alecampo01/Hardware-P3/Diagrama de bloques/diagrama_de_bloques.jpeg

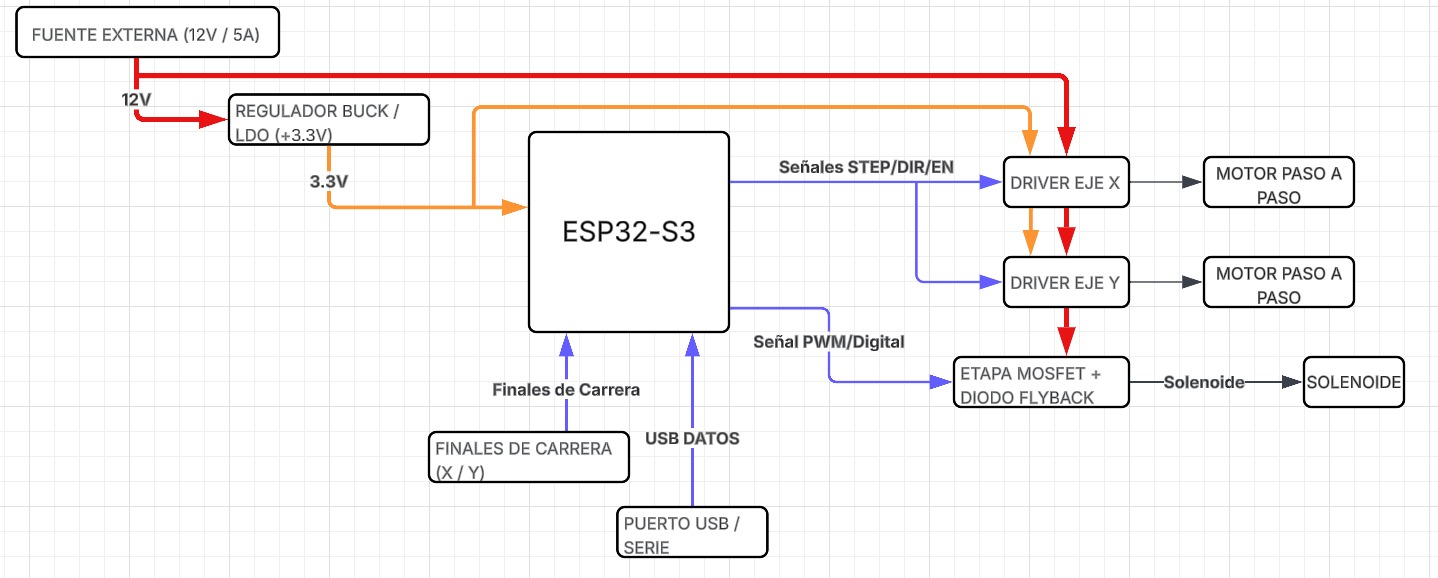
Diagrama de bloques/diagrama_de_bloques.jpeg
