alecampo01/Hardware-P3/ListaDeCompras.xlsx

 | MICROCONTROLADOR
N° | Componente | Cantidad | Precio C/U | Total C/elemento | Link de Compra
1 | ESP32-S3-WROOM-1-N8R2 | 2 | 5.71 | 11.42 | https://www.mouser.com/ProductDetail/Espressif-Systems/ESP32-S3-WROOM-1-N8R2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
2 | Conector de Cable JST XH2.54 XH 3Pines 5U | 1 | 0.83 | 0.83 | Conector de Cable JST XH2.54 XH, Conector de Cable de 2,54mm, 2/3/4/5/6/7/8 Pines, enchufe macho y hembra, 10cm, 20cm de longitud, 26AWG, 5 Juegos - AliExpress (https://es.aliexpress.com/item/1005007460897865.html?curPageLogUid=QL9FQO7aCmdz)
3 | USB-C | 2 | 0.94 | 1.88 | https://www.mouser.com/ProductDetail/GCT/USB4105-GF-A?qs=KUoIvG%2F9IlY%2FMLlBMpStpA%3D%3D
4 | TS-1088-AR02016 SMD 10U | 1 | 0.93 | 0.93 | (10/50/100 piezas) TS-1088-AR02016 SMD 4x3mm Botón pulsador redondo unipolar de 1.6N 4x3x2mm Interruptor táctil de montaje en superficie (https://es.aliexpress.com/item/1005011943648412.html?curPageLogUid=kW8MJiTtlRvl)
5 | B330-13-F | 1 | 0.63 | 0.63 | https://www.mouser.com/ProductDetail/Diodes-Incorporated/B330-13-F?qs=5Tgt%2F%252B%252B8UCehJdUN1WXRnw%3D%3D
6 | IRLZ44NSTRLPBF | 1 | 1.85 | 1.85 | https://www.mouser.com/ProductDetail/Infineon-Technologies/IRLZ44NSTRLPBF?qs=9%252BKlkBgLFf1LijFJvUznEg%3D%3D
7 | TAU-0826B 20N | 1 | 1.29 | 1.29 | https://es.aliexpress.com/item/32618031228.html?curPageLogUid=pLduYfAZWpfP
8 | Capacitor 22uF/25V | 2 | 0.54 | 1.08 | https://www.mouser.com/ProductDetail/Samsung-Electro-Mechanics/CL21X226MAYNNWE
9 | Capacitor 0.1uF=100nF/50V | 4 | 0.14 | 0.56 | https://www.mouser.com/ProductDetail/KEMET/C0805C104J5RAC3123?qs=gbgtKHXraGH3IyMRQDl%252BcQ%3D%3D
10 | Capacitor 1uF | 2 | 0.26 | 0.52 | https://www.mouser.com/ProductDetail/KEMET/C0805C105M4REC7210
11 | Resistor 100ohm | 2 | 0.1 | 0.2 | https://www.mouser.com/ProductDetail/Bourns/CR0805-JW-101ELF?qs=wL7NMIHXUPl5EcPQbx1sug%3D%3D
12 | Resistor 10kohm | 2 | 0.1 | 0.2 | https://www.mouser.com/ProductDetail/Bourns/CR0805-JW-103ELF?qs=3T0Ne7aOLxCPz7FUKqmeVw%3D%3D
13 | Resistor 220ohm | 2 | 0.1 | 0.2 | https://www.mouser.com/ProductDetail/Panasonic/ERJ-6GEYJ221V?qs=mVvrpt%2FmFGaxvxGYT57NXw%3D%3D
14 | Resistor 5.1kohm | 4 | 0.1 | 0.4 | https://www.mouser.com/ProductDetail/Bourns/CR0805-FX-5101ELF
15 | SS-01GL | 2 | 3.4 | 6.8 | https://www.mouser.com/ProductDetail/Omron-Electronics/SS-01GL?qs=Pjd0UV7BHP91yVT1VU12sw%3D%3D
 |  |  | Total | 28.79
 | DRIVERS
N° | Componentes | Cantidad | Precio C/U | Total C/elemento | Link de Compra
1 | DRV8825 | 3 | 4.99 | 14.97 | https://www.mouser.com/ProductDetail/Texas-Instruments/DRV8825PWPR?qs=L4ss%2FyqpMWRQV%252B0JWK8r%2FQ%3D%3D
2 | Conector de Cable JST XH2.54 XH 4Pines 5U | 1 | 0.9 | 0.9 | https://es.aliexpress.com/item/1005007460897865.html
3 | NEMA17 17HS4401 3U | 1 | 21.58 | 21.58 | https://es.aliexpress.com/item/1005006111249881.html?curPageLogUid=EycNEFFyzhpI
4 | Capacitor Electrolitico 100uF/35V | 3 | 0.35 | 1.05 | https://www.mouser.com/ProductDetail/Wurth-Elektronik/865080545012
5 | Capacitor Electrolitico 0.01uF/50V | 3 | 2.54 | 7.62 | https://www.mouser.com/ProductDetail/KEMET/C0805C103F5GACAUTO
6 | Capacitor 0.1uF=100nF/50V | 6 | 0.14 | 0.84 | https://www.mouser.com/ProductDetail/KEMET/C0805C104J5RAC3123?qs=gbgtKHXraGH3IyMRQDl%252BcQ%3D%3D
7 | Capacitor 0.47uF/25V | 3 | 0.23 | 0.69 | https://www.mouser.com/ProductDetail/KEMET/C0805C474M3RECTU
8 | Resistor 1Mohm | 3 | 0.1 | 0.3 | https://www.mouser.com/ProductDetail/Bourns/CR0805-FX-1004ELF?qs=tknLyCMIRbOGJekSMom0SQ%3D%3D
9 | Resistor 0.2ohm | 6 | 0.2 | 1.2 | https://www.mouser.com/ProductDetail/Bourns/CRL0805-JW-R200ELF?qs=OcJ73dDx4S2T7WJh28otdg%3D%3D
10 | Resistor 50kohm | 3 | 2.25 | 6.75 | https://www.mouser.com/ProductDetail/Vishay-Draloric/TNPU080550K0AZEN00?qs=bAKSY%2FctAC6QhhNTu29n1w%3D%3D
11 | Resistor 30kohm | 3 | 0.1 | 0.3 | https://www.mouser.com/ProductDetail/Bourns/CR0805-FX-3002ELF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
12 | Resistor 10kohm | 3 | 0.1 | 0.3 | https://www.mouser.com/ProductDetail/Bourns/CR0805-FX-1002ELF?qs=tknLyCMIRbPr%252BDD0s0nG9g%3D%3D
 |  |  | Total | 56.5
 | REGULADORES
N° | Componentes | Cantidad | Precio C/U | Total C/elemento | Link de Compra
1 | MP2393GTL-Z | 2 | 1.5 | 3 | https://www.mouser.com/ProductDetail/Monolithic-Power-Systems-MPS/MP2393GTL-Z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
2 | LM1117MPX-3.3/NOPB | 1 | 1.04 | 1.04 | https://www.mouser.com/ProductDetail/Texas-Instruments/LM1117MPX-3.3-NOPB?qs=X1J7HmVL2ZHRbBIxXi4utg%3D%3D
3 | LTST-C193KRKT-2A | 2 | 0.17 | 0.34 | https://www.mouser.com/ProductDetail/LITEON/LTST-C193KRKT-2A?qs=gTYE2QTfZfR%2Fn%2F75wQdYig%3D%3D
4 | DMP3130L-7 | 1 | 0.57 | 0.57 | https://www.mouser.com/ProductDetail/Diodes-Incorporated/DMP3130L-7?qs=oUsD4qhOtFzo1DjIYBcgCA%3D%3D
5 | BAT760-7 | 1 | 0.55 | 0.55 | https://www.mouser.com/ProductDetail/Diodes-Incorporated/BAT760-7?qs=JV7lzlMm3yKDDyO09xoRbQ%3D%3D
6 | L 4.7uH | 2 | 0.92 | 1.84 | https://www.mouser.com/ProductDetail/Vishay-Dale/IHLP1616BZER4R7M11?qs=gMuw6kkpPFgfyxuC44lHBg%3D%3D
7 | Capacitor 0.1uF=100nF/50V | 4 | 0.14 | 0.56 | https://www.mouser.com/ProductDetail/KEMET/C0805C104J5RAC3123?qs=gbgtKHXraGH3IyMRQDl%252BcQ%3D%3D
8 | Capacitor 22uF/25V | 6 | 0.54 | 3.24 | https://www.mouser.com/ProductDetail/Samsung-Electro-Mechanics/CL21X226MAYNNWE
9 | Capacitor 6.8uF/6.3V | 2 | 0.52 | 1.04 | https://www.mouser.com/ProductDetail/KEMET/C0805C685K9PACTM
10 | Capacitor 1uF | 2 | 0.26 | 0.52 | https://www.mouser.com/ProductDetail/KEMET/C0805C105M4REC7210
11 | Capacitor 10pF/35V | 2 | 0.18 | 0.36 | https://www.mouser.com/ProductDetail/KEMET/C0805C100K3RACTU
12 | Tantalum Capacitor 10uF/10V | 2 | 0.47 | 0.94 | https://www.mouser.com/ProductDetail/Vishay-Sprague/293D106X9010B2TE3
13 | Resistor 604kohm | 2 | 0.11 | 0.22 | https://www.mouser.com/ProductDetail/YAGEO/RT0805FRE07604KL
14 | Resistor 20ohm | 2 | 0.11 | 0.22 | https://www.mouser.com/ProductDetail/YAGEO/RC0805DR-0720RL?qs=9h0bZHM%2F3zKGUzWhuF%2FRhg%3D%3D
15 | Resistor 15kohm | 2 | 0.1 | 0.2 | https://www.mouser.com/ProductDetail/Bourns/CR0805-FX-1502ELF?qs=Hqdsf0hGw%2FCN5sNalLmn%252BA%3D%3D
16 | Resistor 40.2kohm | 2 | 0.1 | 0.2 | https://www.mouser.com/ProductDetail/YAGEO/RT0805FRE0740K2L
17 | Resistor 7.68kohm | 2 | 0.1 | 0.2 | https://www.mouser.com/ProductDetail/YAGEO/RT0805DRE077K68L?qs=sGAEpiMZZMtlubZbdhIBIKm0gsRX2fVkGmK9ppNE60o%3D
18 | Resistor 10kohm | 1 | 0.1 | 0.1 | https://www.mouser.com/ProductDetail/Bourns/CR0805-FX-1002ELF?qs=tknLyCMIRbPr%252BDD0s0nG9g%3D%3D
19 | Resistor 100ohm | 1 | 0.1 | 0.1 | https://www.mouser.com/ProductDetail/Bourns/CR0805-JW-101ELF?qs=wL7NMIHXUPl5EcPQbx1sug%3D%3D
 |  |  | Total | 15.24
 | COMPONENTES DONADOS
N° | Componentes | Cantidad | Precio C/U | Total C/elemento | Link de Compra
1 | Bornera 2.54mm 2pines 5U | 1 | 4.37 | 4.37 | https://es.aliexpress.com/item/4000867583795.html?curPageLogUid=YPG3fmZDelMp
2 | Fuente 12V/6A 72W | 1 | 8.44 | 8.44 | https://konext.com.py/comprar/fuente-12v-6a/
 |  |  | Total | 12.81
 |  |  | Total Proyecto | 113.34
