alecampo01/Hardware-P3/MAQUINA_DE_BRAILLE_PCB/MAQUINA_DE_BRAILLE_PCB/ass_ets/ADP122AUJZ_3_3_R7/UJ_5_ADI.step

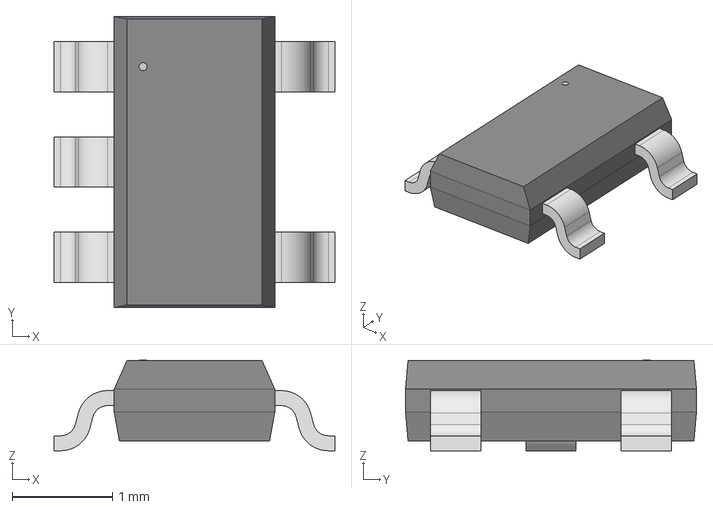
[picture p6: CAD file, 2026-03-28]
MAQUINA_DE_BRAILLE_PCB/MAQUINA_DE_BRAILLE_PCB/ass_ets/ADP122AUJZ_3_3_R7/UJ_5_ADI.step
2.80 x 2.90 x 0.903 mm
