alecampo01/Hardware-P3/MAQUINA_DE_BRAILLE_PCB/MAQUINA_DE_BRAILLE_PCB/ass_ets/BAT760_7/BAT760-7.step

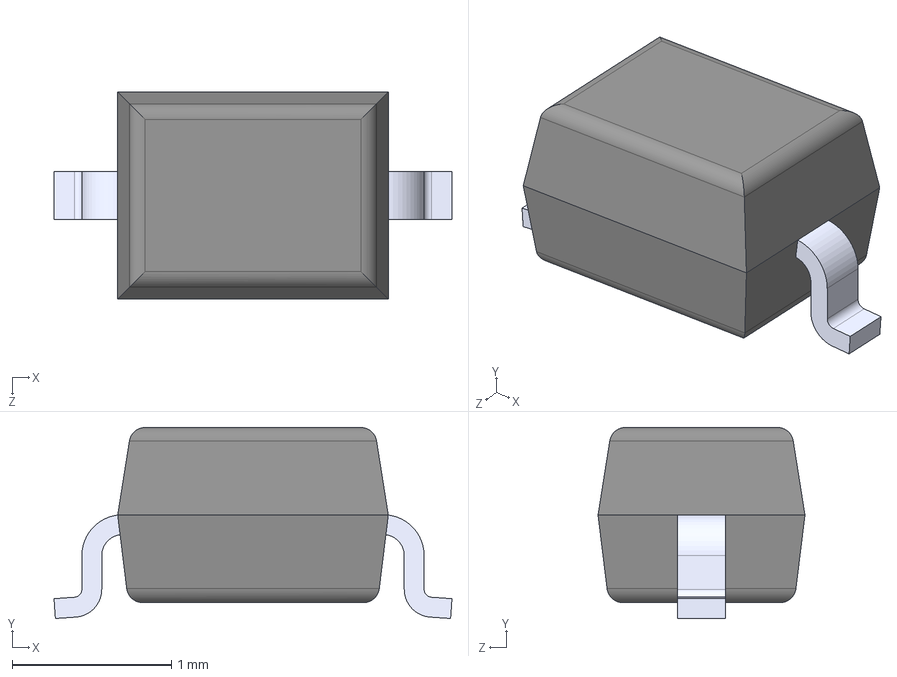
[picture p7: CAD file, 2026-03-28]
MAQUINA_DE_BRAILLE_PCB/MAQUINA_DE_BRAILLE_PCB/ass_ets/BAT760_7/BAT760-7.step
2.50 x 1.20 x 1.30 mm
