alecampo01/Hardware-P3/MAQUINA_DE_BRAILLE_PCB/MAQUINA_DE_BRAILLE_PCB/ass_ets/LTST-C193KRKT-2A/LTST-C193KRKT-2A.STEP

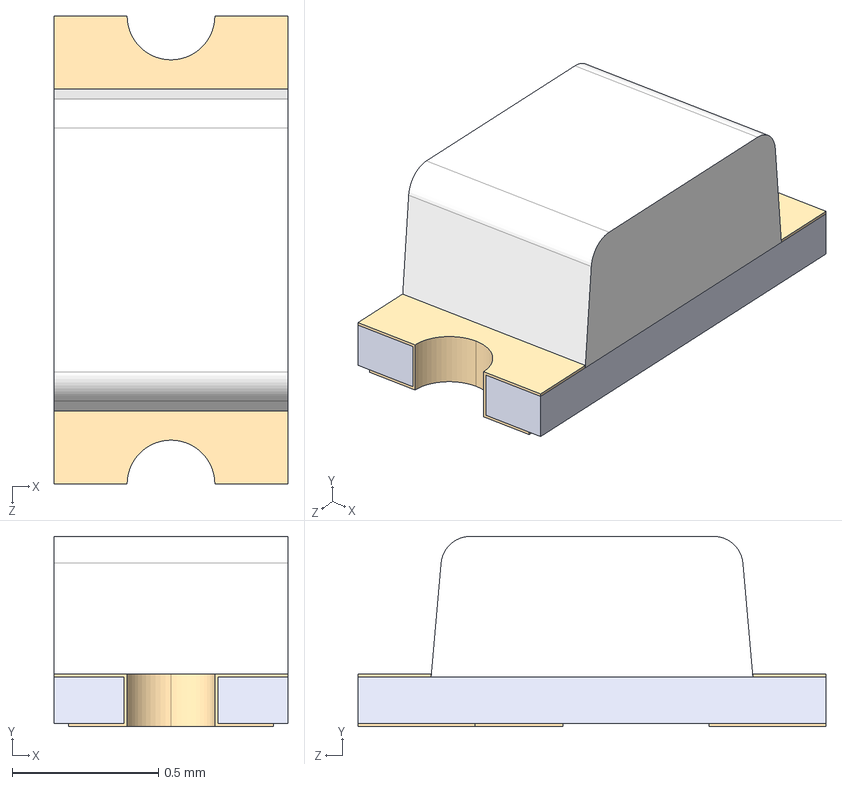
[picture p8: CAD file, 2026-03-28]
MAQUINA_DE_BRAILLE_PCB/MAQUINA_DE_BRAILLE_PCB/ass_ets/LTST-C193KRKT-2A/LTST-C193KRKT-2A.STEP
0.8 x 0.65 x 1.60 mm
