alecampo01/Hardware-P3/MAQUINA_DE_BRAILLE_PCB/MAQUINA_DE_BRAILLE_PCB/MAQUINA_DE_BRAILLE.kicad_pcb

## KiCad design MAQUINA_DE_BRAILLE_PCB/MAQUINA_DE_BRAILLE_PCB/MAQUINA_DE_BRAILLE.kicad_pcb (2026-04-25)

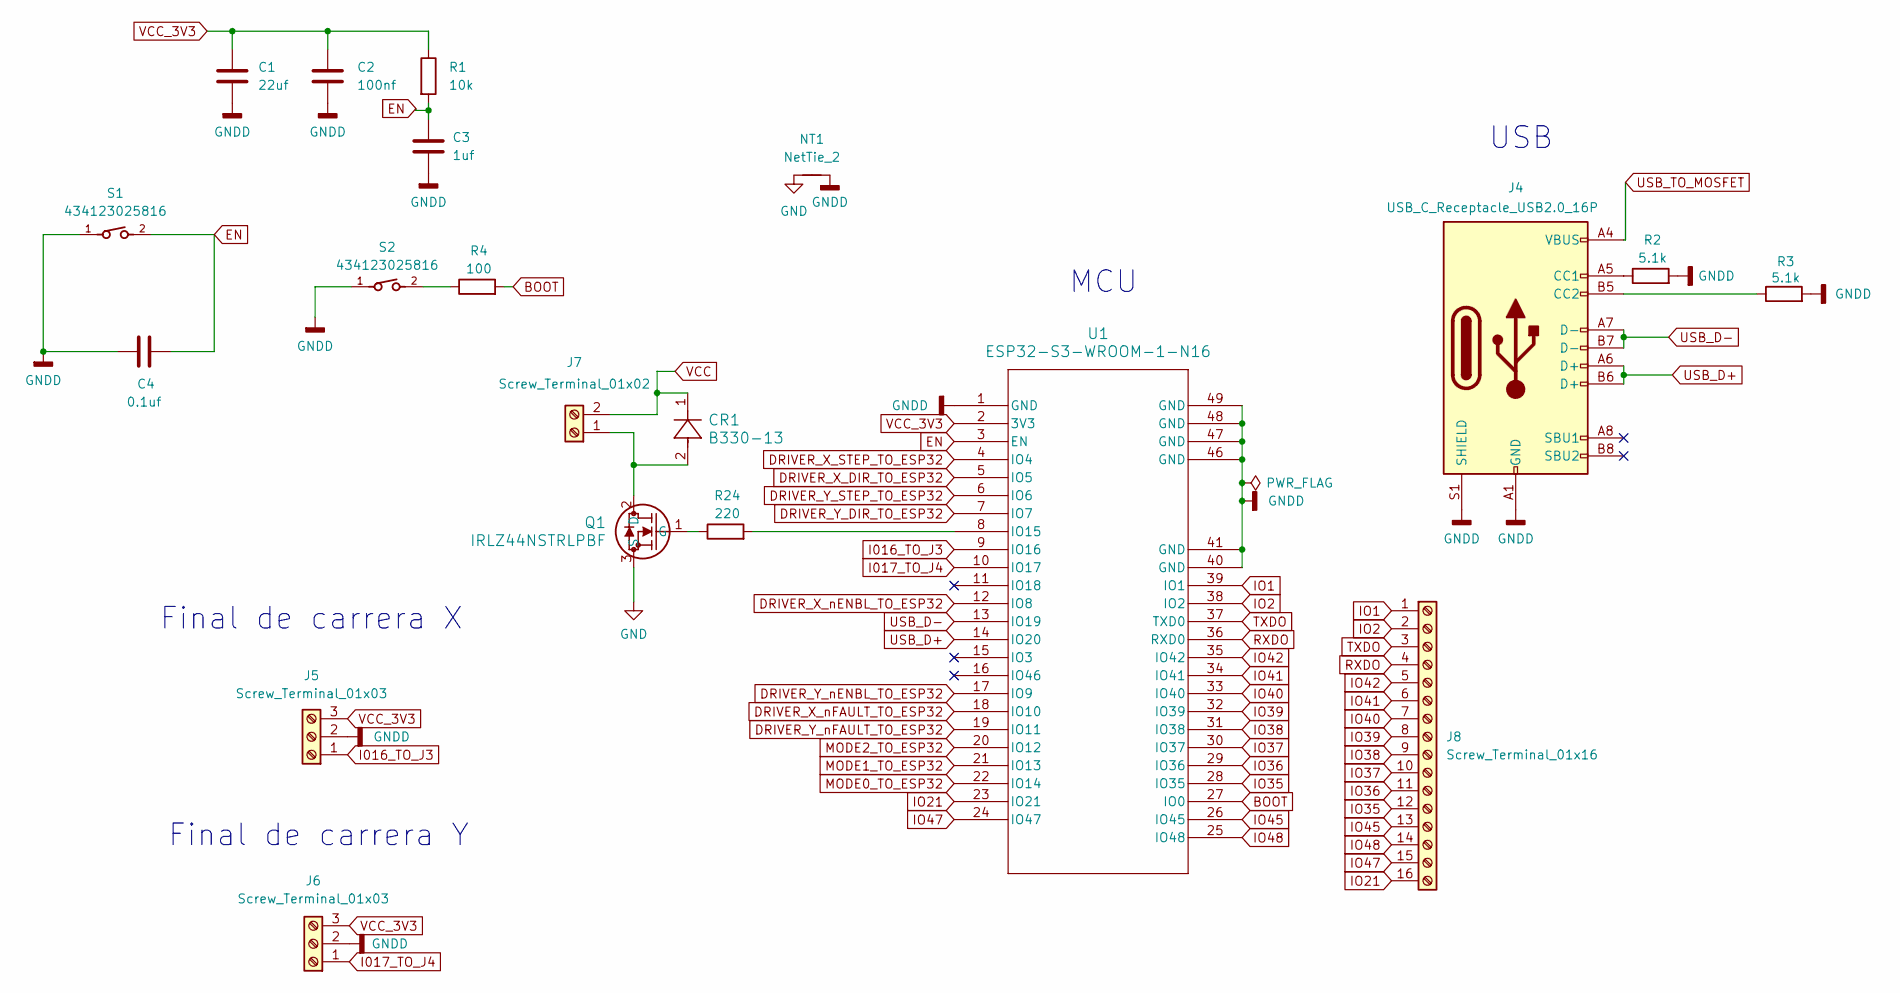
[picture p9: schematic ESP32.kicad_sch]

Parts:
C1: 22uf; C_0805_2012Metric_Pad1.18x1.45mm_HandSolder
C2: 100nf; C_0805_2012Metric_Pad1.18x1.45mm_HandSolder
C3: 1uf; C_0805_2012Metric_Pad1.18x1.45mm_HandSolder
C4: 0.1uf; C_0805_2012Metric_Pad1.18x1.45mm_HandSolder
CR1: B330-13; SMC_DIO
J4: USB_C_Receptacle_USB2.0_16P; USB_C_Receptacle_GCT_USB4105-xx-A_16P_TopMnt_Horizontal
J5, J6: Screw_Terminal_01x03; TerminalBlock_Xinya_XY308-2.54-3P_1x03_P2.54mm_Horizontal
J7: Screw_Terminal_01x02; TerminalBlock_Phoenix_MKDS-3-2-5.08_1x02_P5.08mm_Horizontal
J8: Screw_Terminal_01x16; TerminalBlock_Xinya_XY308-2.54-16P_1x16_P2.54mm_Horizontal
NT1: NetTie_2; NetTie-2_SMD_Pad2.0mm
Q1: IRLZ44NSTRLPBF; NMOSGDS_D2PAK_INF
R1: 10k; R_0805_2012Metric_Pad1.20x1.40mm_HandSolder
R2, R3: 5.1k; R_0805_2012Metric_Pad1.20x1.40mm_HandSolder
R4: 100; R_0805_2012Metric_Pad1.20x1.40mm_HandSolder
R24: 220; R_0805_2012Metric_Pad1.20x1.40mm_HandSolder
S1, S2: 434123025816
U1: ESP32-S3-WROOM-1-N16; ESP32-S3-WROOM-1_EXP

Connections:
BOOT: R4.2, U1.27 (IO0)
DRIVER_X_DIR_TO_ESP32: U1.5 (IO5); also elsewhere on the board
DRIVER_X_STEP_TO_ESP32: U1.4 (IO4); also elsewhere on the board
DRIVER_X_nENBL_TO_ESP32: U1.12 (IO8); also elsewhere on the board
DRIVER_X_nFAULT_TO_ESP32: U1.18 (IO10); also elsewhere on the board
DRIVER_Y_DIR_TO_ESP32: U1.7 (IO7); also elsewhere on the board
DRIVER_Y_STEP_TO_ESP32: U1.6 (IO6); also elsewhere on the board
DRIVER_Y_nENBL_TO_ESP32: U1.17 (IO9); also elsewhere on the board
DRIVER_Y_nFAULT_TO_ESP32: U1.19 (IO11); also elsewhere on the board
EN: C3.1, C4.2, R1.2, S1.2, U1.3 (EN); also elsewhere on the board
GND: NT1.1, Q1.3 (S); also elsewhere on the board
GNDD: C1.2, C2.2, C3.2, C4.1, J4.A1 (GND), J4.A12 (GND), J4.B1 (GND), J4.B12 (GND), J4.S1 (SHIELD), J5.2, J6.2, NT1.2, R2.2, R3.2, S1.1, S2.1, U1.1 (GND), U1.40 (GND), U1.41 (GND), U1.42, U1.43, U1.44, U1.45, U1.46 (GND), U1.47 (GND), U1.48 (GND), U1.49 (GND); also elsewhere on the board
I016_TO_J3: J5.1, U1.9 (IO16)
I017_TO_J4: J6.1, U1.10 (IO17)
IO1: J8.1, U1.39 (IO1)
IO2: J8.2, U1.38 (IO2)
IO21: J8.16, U1.23 (IO21)
IO35: J8.12, U1.28 (IO35)
IO36: J8.11, U1.29 (IO36)
IO37: J8.10, U1.30 (IO37)
IO38: J8.9, U1.31 (IO38)
IO39: J8.8, U1.32 (IO39)
IO40: J8.7, U1.33 (IO40)
IO41: J8.6, U1.34 (IO41)
IO42: J8.5, U1.35 (IO42)
IO45: J8.13, U1.26 (IO45)
IO47: J8.15, U1.24 (IO47)
IO48: J8.14, U1.25 (IO48)
MODE0_TO_ESP32: U1.22 (IO14); also elsewhere on the board
MODE1_TO_ESP32: U1.21 (IO13); also elsewhere on the board
MODE2_TO_ESP32: U1.20 (IO12); also elsewhere on the board
unnamed: J4.A5 (CC1), R2.1
unnamed: J4.B5 (CC2), R3.1
unnamed: CR1.2, J7.1, Q1.2 (D)
unnamed: Q1.1 (G), R24.1
unnamed 51: R4.1, S2.2; also elsewhere on the board
unnamed: R24.2, U1.8 (IO15)
RXDO: J8.4, U1.36 (RXD0)
TXDO: J8.3, U1.37 (TXD0)
USB_D+: J4.A6 (D+), J4.B6 (D+), U1.14 (IO20)
USB_D-: J4.A7 (D-), J4.B7 (D-), U1.13 (IO19)
USB_TO_MOSFET: J4.A4 (VBUS), J4.A9 (VBUS), J4.B4 (VBUS), J4.B9 (VBUS); also elsewhere on the board
VCC: CR1.1, J7.2; also elsewhere on the board
VCC_3V3: C1.1, C2.1, J5.3, J6.3, R1.1, U1.2 (3V3); also elsewhere on the board

Notes on the sheet:
USB
MCU
Final de carrera Y
Final de carrera X

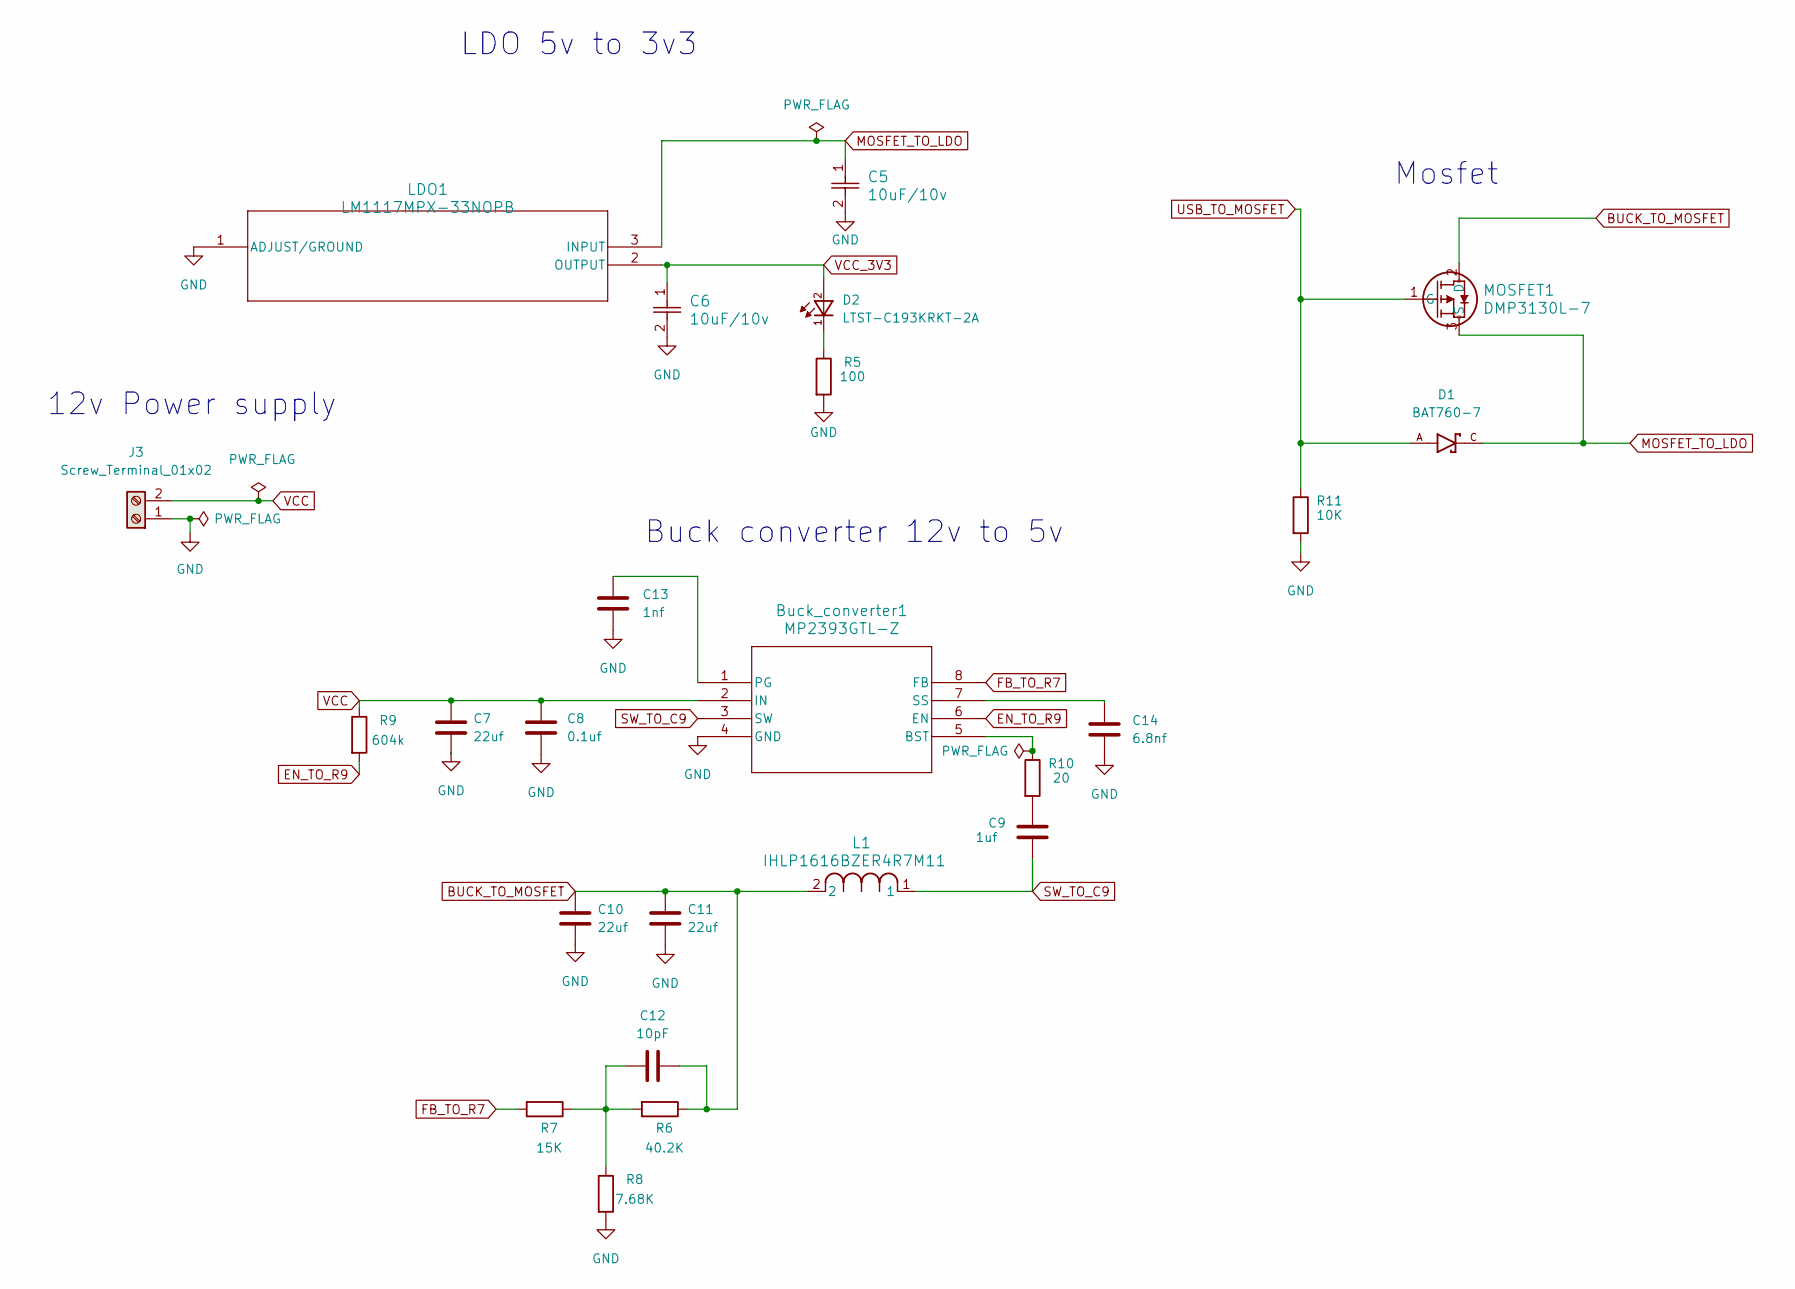
[picture p10: schematic POWER.kicad_sch]

Parts:
Buck_converter1: MP2393GTL-Z; SOT583_MP2393
C5, C6: 10uF/10v; CAP_293D_B_VIS
C7, C10, C11: 22uf; C_0805_2012Metric_Pad1.18x1.45mm_HandSolder
C8: 0.1uf; C_0805_2012Metric_Pad1.18x1.45mm_HandSolder
C9: 1uf; C_0805_2012Metric_Pad1.18x1.45mm_HandSolder
C12: 10pF; C_0805_2012Metric_Pad1.18x1.45mm_HandSolder
C13: 1nf; C_0805_2012Metric_Pad1.18x1.45mm_HandSolder
C14: 6.8nf; C_0805_2012Metric_Pad1.18x1.45mm_HandSolder
D1: BAT760-7; SOD2513X120N; PARTREV 9-2
D2: LTST-C193KRKT-2A; 0603
J3: Screw_Terminal_01x02; TerminalBlock_Phoenix_MKDS-3-2-5.08_1x02_P5.08mm_Horizontal
L1: IHLP1616BZER4R7M11; IND_IHLP-1616BZ_VIS
LDO1: LM1117MPX-33NOPB; SOT223-318H_OSI
MOSFET1: DMP3130L-7; SOT-23_DMP3130L_DIO
R5: 100; R_0805_2012Metric_Pad1.20x1.40mm_HandSolder
R6: 40.2K; R_0805_2012Metric_Pad1.20x1.40mm_HandSolder
R7: 15K; R_0805_2012Metric_Pad1.20x1.40mm_HandSolder
R8: 7.68K; R_0805_2012Metric_Pad1.20x1.40mm_HandSolder
R9: 604k; R_0805_2012Metric_Pad1.20x1.40mm_HandSolder
R10: 20; R_0805_2012Metric_Pad1.20x1.40mm_HandSolder
R11: 10K; R_0805_2012Metric_Pad1.20x1.40mm_HandSolder

Connections:
EN_TO_R9: Buck_converter1.6 (EN), R9.2
FB_TO_R7: Buck_converter1.8 (FB), R7.2
GND: Buck_converter1.4 (GND), C5.2, C6.2, C7.2, C8.2, C10.2, C11.2, C13.2, C14.2, J3.1, LDO1.1 (ADJUST/GROUND), R5.2, R8.2, R11.2; also elsewhere on the board
unnamed: Buck_converter1.5 (BST), R10.1
unnamed: Buck_converter1.1 (PG), C13.1
unnamed: Buck_converter1.7 (SS), C14.1
unnamed: C9.1, R10.2
unnamed: C12.1, R6.2, R7.1, R8.1
unnamed: D2.1, R5.1
SW_TO_C9: Buck_converter1.3 (SW), C9.2, L1.1
USB_TO_MOSFET: D1.A, MOSFET1.1 (G), R11.1; also elsewhere on the board
VCC: Buck_converter1.2 (IN), C7.1, C8.1, J3.2, R9.1; also elsewhere on the board
VCC_3V3: C6.1, D2.2, LDO1.2 (OUTPUT); also elsewhere on the board

Notes on the sheet:
Buck converter 12v to 5v
Mosfet
12v Power supply
LDO 5v to 3v3

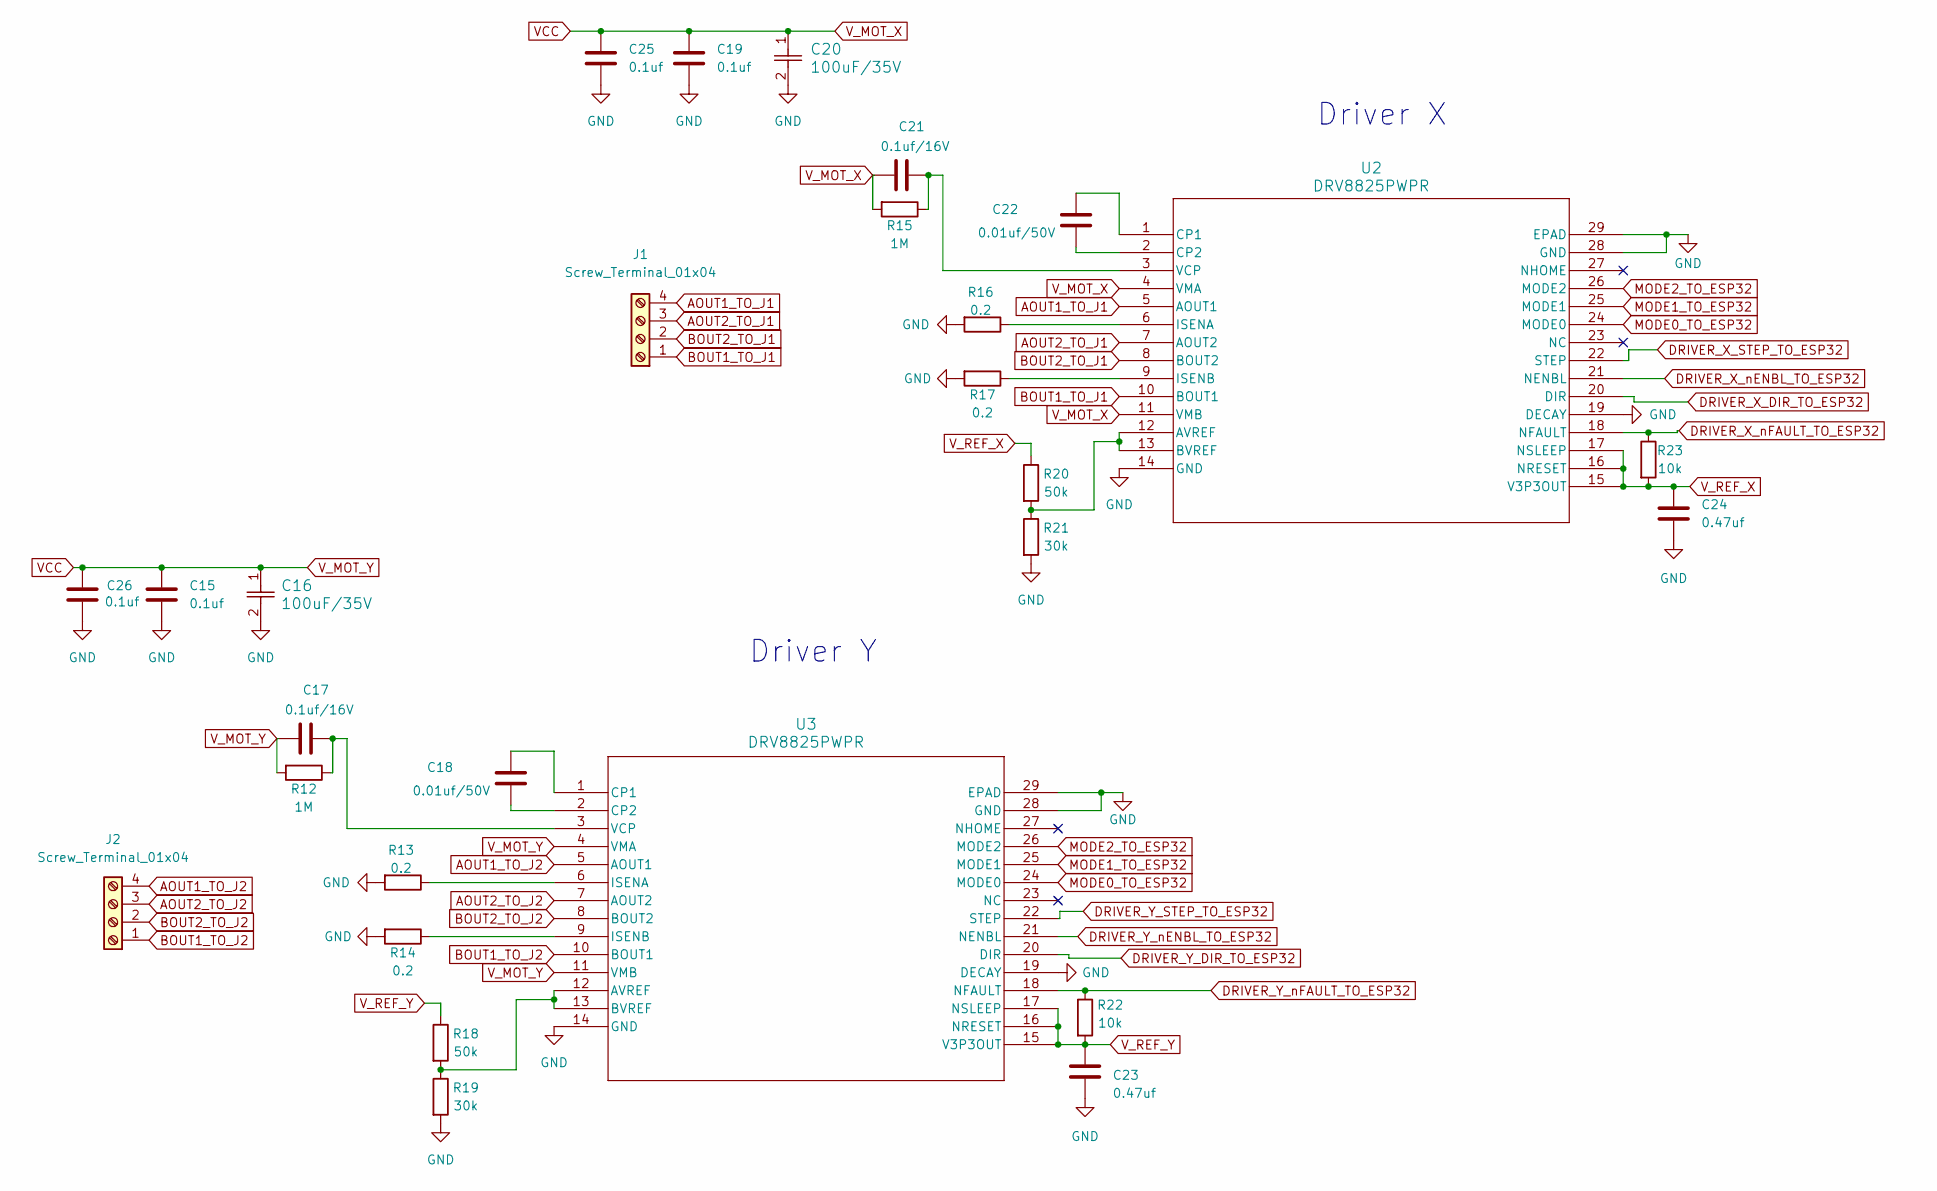
[picture p11: schematic DRIVERS.kicad_sch]

Parts:
C15, C19, C25, C26: 0.1uf; C_0805_2012Metric_Pad1.18x1.45mm_HandSolder
C16, C20: 100uF/35V; CAP_WCAP-ASLI_06p3X07p7_WRE
C17, C21: 0.1uf/16V; C_0805_2012Metric_Pad1.18x1.45mm_HandSolder
C18, C22: 0.01uf/50V; C_0805_2012Metric_Pad1.18x1.45mm_HandSolder
C23, C24: 0.47uf; C_0805_2012Metric_Pad1.18x1.45mm_HandSolder
J1, J2: Screw_Terminal_01x04; TerminalBlock_Xinya_XY308-2.54-4P_1x04_P2.54mm_Horizontal
R12, R15: 1M; R_0805_2012Metric_Pad1.20x1.40mm_HandSolder
R13, R14, R16, R17: 0.2; R_0805_2012Metric_Pad1.20x1.40mm_HandSolder
R18, R20: 50k; R_0805_2012Metric_Pad1.20x1.40mm_HandSolder
R19, R21: 30k; R_0805_2012Metric_Pad1.20x1.40mm_HandSolder
R22, R23: 10k; R_0805_2012Metric_Pad1.20x1.40mm_HandSolder
U2, U3: DRV8825PWPR; PWP28_5P18X3P1

Connections:
AOUT1_TO_J1: J1.4, U2.5 (AOUT1)
AOUT1_TO_J2: J2.4, U3.5 (AOUT1)
AOUT2_TO_J1: J1.3, U2.7 (AOUT2)
AOUT2_TO_J2: J2.3, U3.7 (AOUT2)
BOUT1_TO_J1: J1.1, U2.10 (BOUT1)
BOUT1_TO_J2: J2.1, U3.10 (BOUT1)
BOUT2_TO_J1: J1.2, U2.8 (BOUT2)
BOUT2_TO_J2: J2.2, U3.8 (BOUT2)
DRIVER_X_DIR_TO_ESP32: U2.20 (DIR); also elsewhere on the board
DRIVER_X_STEP_TO_ESP32: U2.22 (STEP); also elsewhere on the board
DRIVER_X_nENBL_TO_ESP32: U2.21 (NENBL); also elsewhere on the board
DRIVER_X_nFAULT_TO_ESP32: R23.1, U2.18 (NFAULT); also elsewhere on the board
DRIVER_Y_DIR_TO_ESP32: U3.20 (DIR); also elsewhere on the board
DRIVER_Y_STEP_TO_ESP32: U3.22 (STEP); also elsewhere on the board
DRIVER_Y_nENBL_TO_ESP32: U3.21 (NENBL); also elsewhere on the board
DRIVER_Y_nFAULT_TO_ESP32: R22.1, U3.18 (NFAULT); also elsewhere on the board
GND: C15.2, C16.2, C19.2, C20.2, C23.2, C24.2, C25.2, C26.2, R13.2, R14.2, R16.2, R17.2, R19.2, R21.2, U2.14 (GND), U2.19 (DECAY), U2.28 (GND), U2.29 (EPAD), U3.14 (GND), U3.19 (DECAY), U3.28 (GND), U3.29 (EPAD); also elsewhere on the board
MODE0_TO_ESP32: U2.24 (MODE0), U3.24 (MODE0); also elsewhere on the board
MODE1_TO_ESP32: U2.25 (MODE1), U3.25 (MODE1); also elsewhere on the board
MODE2_TO_ESP32: U2.26 (MODE2), U3.26 (MODE2); also elsewhere on the board
unnamed: R20.2, R21.1, U2.12 (AVREF), U2.13 (BVREF)
unnamed: C22.1, U2.1 (CP1)
unnamed: C22.2, U2.2 (CP2)
unnamed: R16.1, U2.6 (ISENA)
unnamed: R17.1, U2.9 (ISENB)
unnamed: C21.1, R15.1, U2.3 (VCP)
unnamed: R18.2, R19.1, U3.12 (AVREF), U3.13 (BVREF)
unnamed: C18.1, U3.1 (CP1)
unnamed: C18.2, U3.2 (CP2)
unnamed: R13.1, U3.6 (ISENA)
unnamed: R14.1, U3.9 (ISENB)
unnamed: C17.1, R12.1, U3.3 (VCP)
VCC: C15.1, C16.1, C17.2, C19.1, C20.1, C21.2, C25.1, C26.1, R12.2, R15.2, U2.4 (VMA), U2.11 (VMB), U3.4 (VMA), U3.11 (VMB); also elsewhere on the board
V_REF_X: C24.1, R20.1, R23.2, U2.15 (V3P3OUT), U2.16 (NRESET), U2.17 (NSLEEP)
V_REF_Y: C23.1, R18.1, R22.2, U3.15 (V3P3OUT), U3.16 (NRESET), U3.17 (NSLEEP)

Notes on the sheet:
Driver Y
Driver X

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
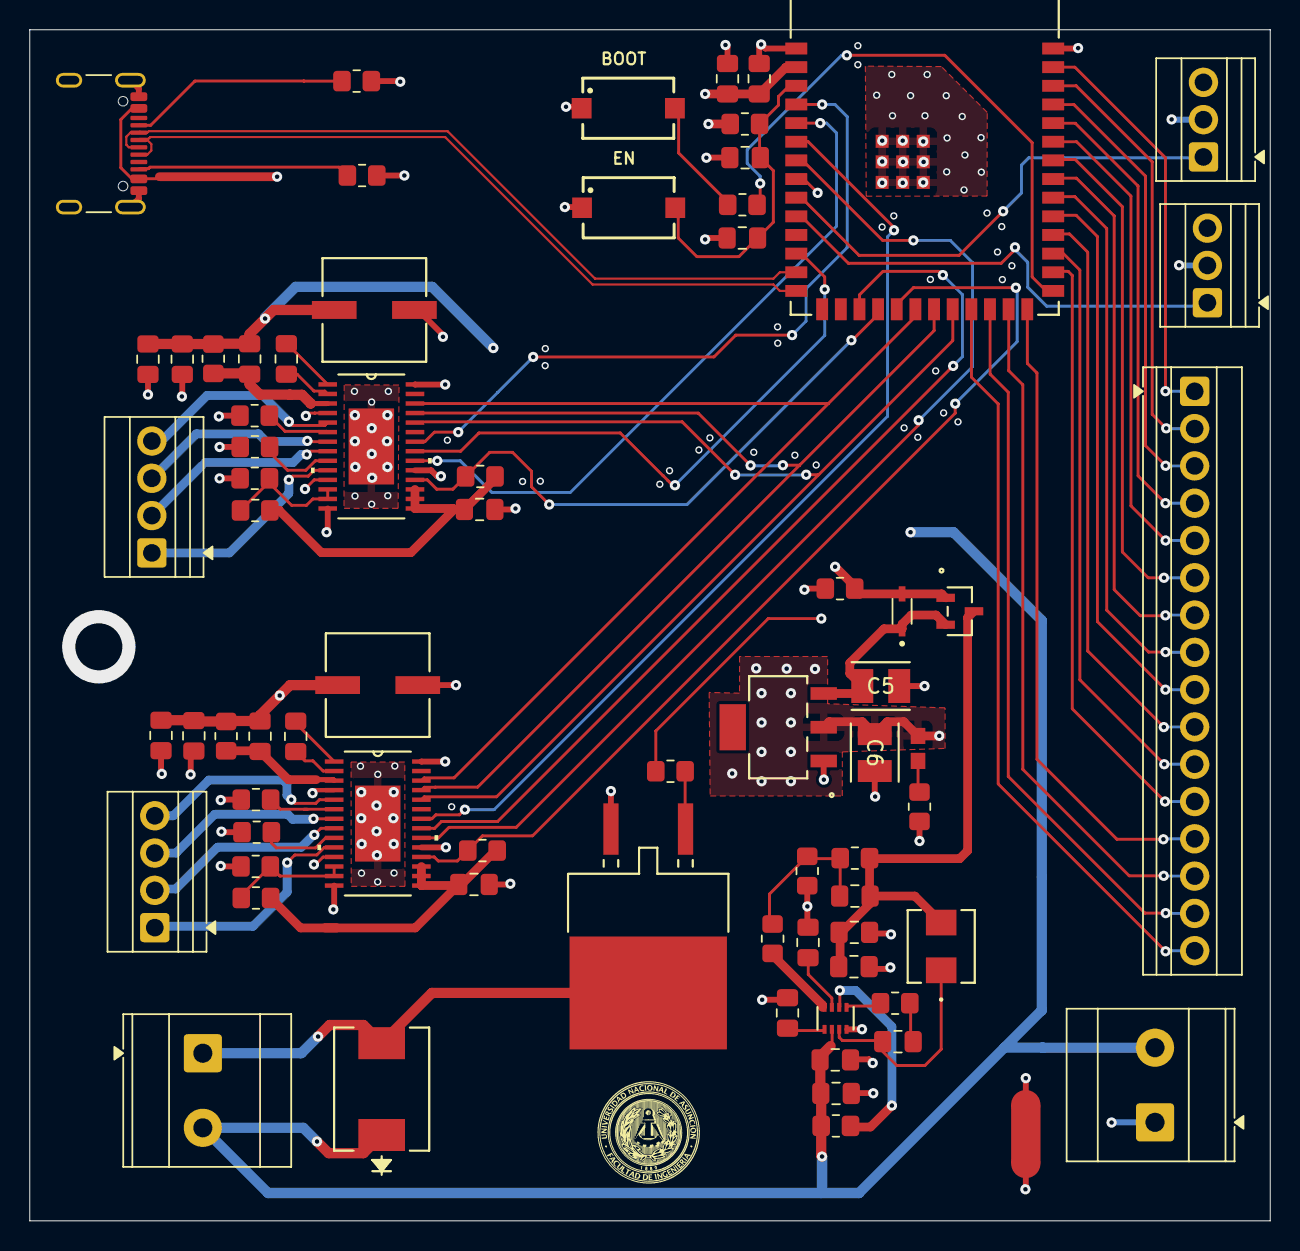
[picture p12: board MAQUINA_DE_BRAILLE.kicad_pcb from above]

Board: 4 copper layers, 84.5 x 81.1 mm, 72 parts (0 on the bottom side), 77 nets.

Other parts of the board:
BOOT: 434123025816
EN: 434123025816

Their connections:
EN: EN.2; also elsewhere on the board
GNDD: BOOT.1, EN.1; also elsewhere on the board
unnamed 51: BOOT.2; also elsewhere on the board
