alecampo01/Hardware-P3/(commit log)

2026-03-28 Primer proyecto
    [BAT760-7.step, DRIVERS.kicad_sch, ESP32.kicad_sch, LTST-C193KRKT-2A.STEP, MAQUINA_DE_BRAILLE.kicad_pcb, MAQUINA_DE_BRAILLE.kicad_sch, POWER.kicad_sch, UJ_5_ADI.step]
2026-03-29 last update
    [DRIVERS.kicad_sch, MAQUINA_DE_BRAILLE.kicad_pcb]
2026-03-29 fabri puto
    [ESP32.kicad_sch, MAQUINA_DE_BRAILLE.kicad_pcb]
2026-03-29 carga de la lista
    [BAT760-7.step, DRIVERS.kicad_sch, ESP32.kicad_sch, LTST-C193KRKT-2A.STEP, ListaDeCompras.xlsx, MAQUINA_DE_BRAILLE.kicad_pcb, MAQUINA_DE_BRAILLE.kicad_sch, POWER.kicad_sch]
